chcode07/Audio_Amp/Schematic.pdf

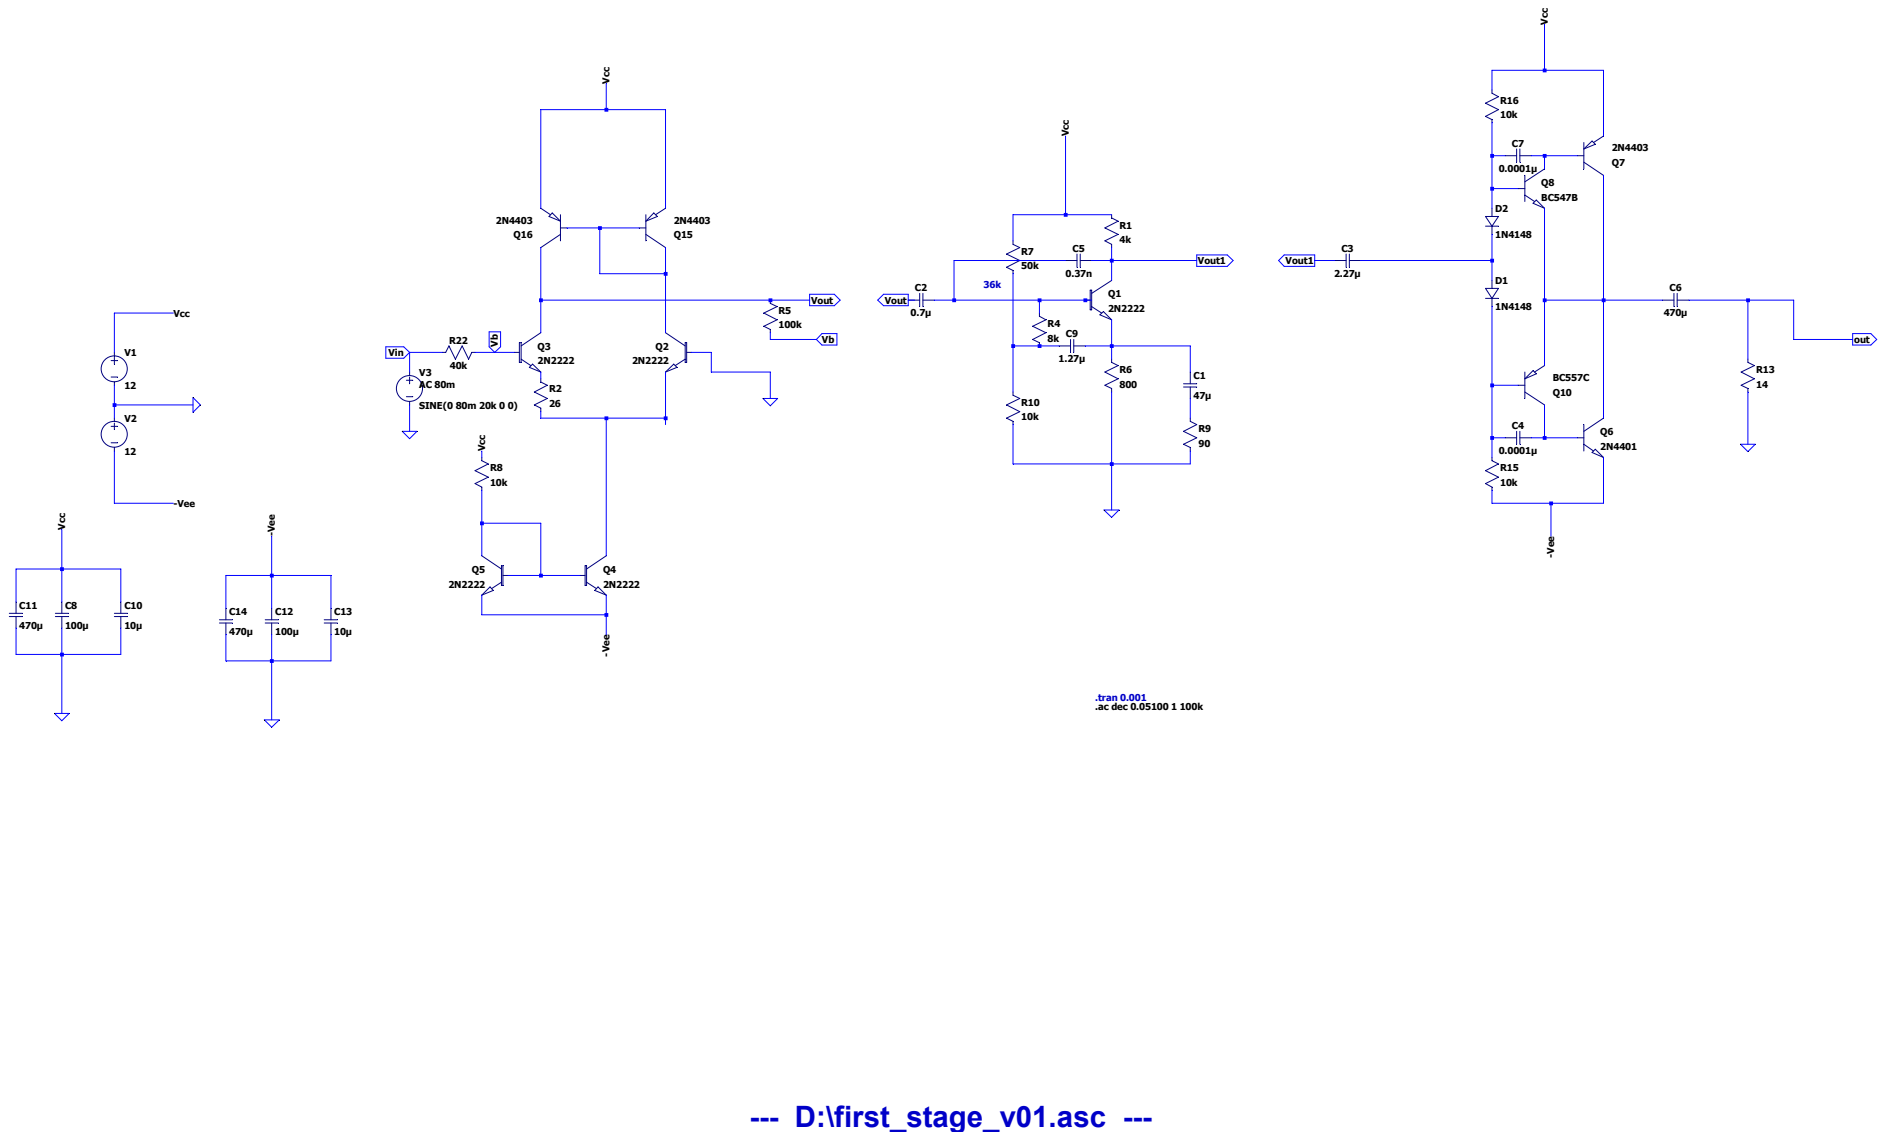
[picture p10: page 1]
