chcode07/Audio_Amp/first_stage_v01.asc

C1: cap; 47µ; V=6.3 Irms=0 Rser=0 Lser=0
C2: cap; 0.7µ; V=6.3 Irms=2.8 Rser=0.0497656 Lser=0
C3: cap; 2.27µ
C4: cap; 0.0001µ
C5: cap; 0.89n
C6: cap; 470µ; V=6.3 Irms=2.84 Rser=0.031 Lser=0
C7: cap; 0.0001µ
C8: cap; 100µ
C9: cap; 1.27µ
C10: cap; 10µ
C11: cap; 470µ
C12: cap; 100µ
C13: cap; 10µ
C14: cap; 470µ
D1: diode; 1N4148
D2: diode; 1N4148
Q1: npn2; 2N2222
Q2: npn2; 2N2222
Q3: npn2; 2N2222
Q4: npn2; 2N2222
Q5: npn2; 2N2222
Q6: npn; 2N4401
Q7: pnp; 2N4403
Q8: npn; BC547B
Q10: pnp; BC557C
Q15: pnp; 2N4403
Q16: pnp; 2N4403
R1: res; 4k
R2: res; 26
R4: res; 8k
R5: res; 100k
R6: res; 800
R7: res; 50k
R8: res; 10k
R9: res; 90; tol=1 pwr=0.1
R10: res; 10k
R13: res; 14
R15: res; 20k
R16: res; 20k
R22: res; 40k
V1: voltage; 12
V2: voltage; 12
V3: voltage; SINE(0 80m 10k 0 0); AC 80m
Named nets: 0, Vout, Vcc, -Vee, Vin, Vout1, out, Vb
.tran 0.1
.ac dec 0.05100 1 100k
36k
